ConnorBurken/CS498-IoT_Final_Project_Google_Glass/3D Printer Files/GG Part A v1.3.stl

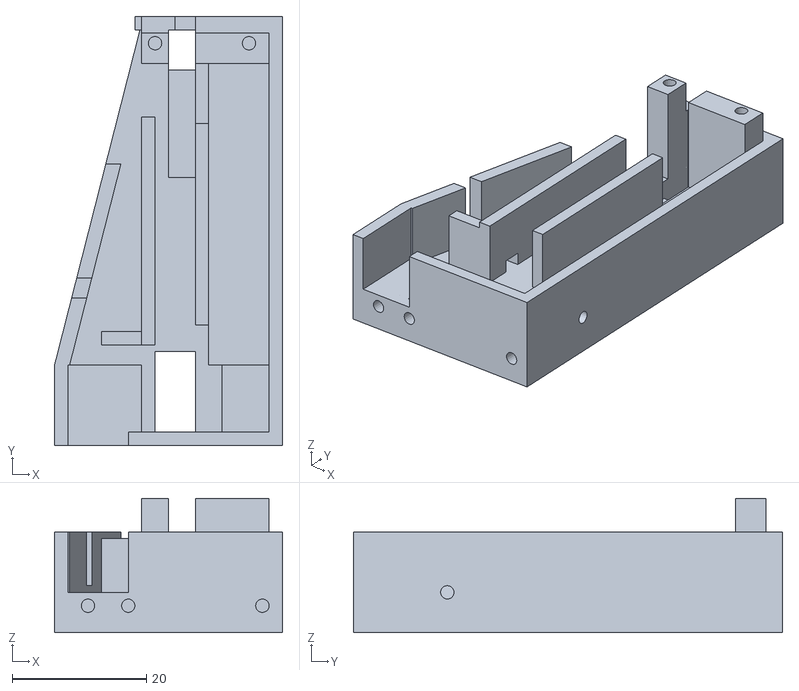
[picture p9: CAD file, 2023-01-03]
3D Printer Files/GG Part A v1.3.stl
34.0 x 64.0 x 20.0
