ConnorBurken/CS498-IoT_Final_Project_Google_Glass/3D Printer Files/GG Part H v1.3.stl

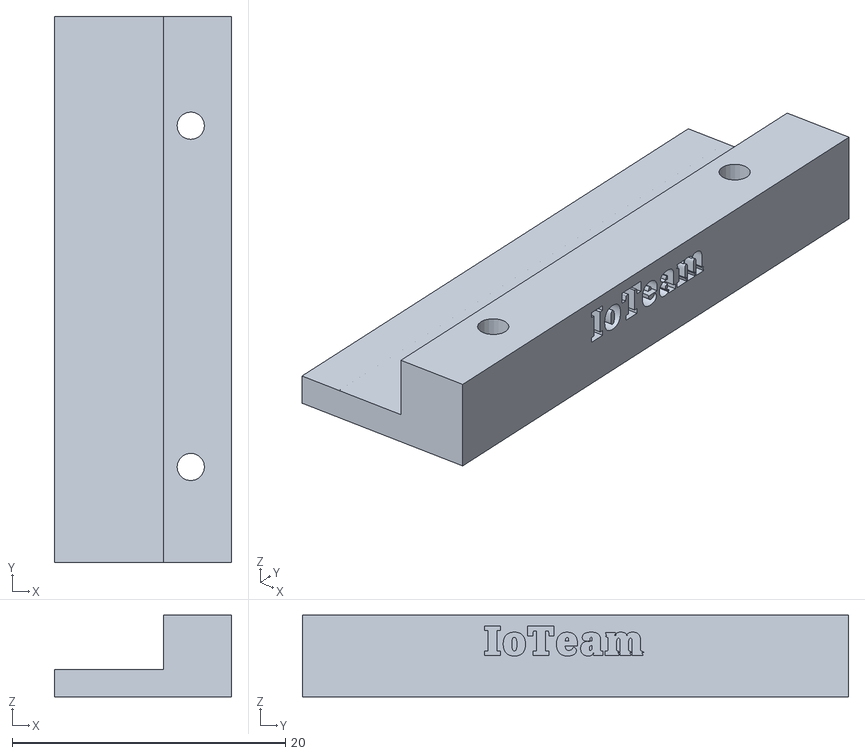
[picture p10: CAD file, 2023-01-03]
3D Printer Files/GG Part H v1.3.stl
13.0 x 40.0 x 6.00
