ConnorBurken/CS498-IoT_Final_Project_Google_Glass/3D Printer Files/GG Part E v1.3.stl

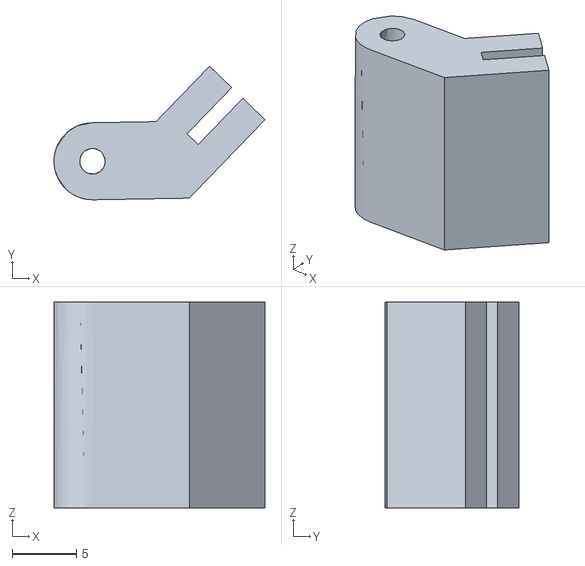
[picture p11: CAD file, 2023-01-03]
3D Printer Files/GG Part E v1.3.stl
16.4 x 10.4 x 16.0
