ConnorBurken/CS498-IoT_Final_Project_Google_Glass/3D Printer Files/Google_Glass_Test.stl

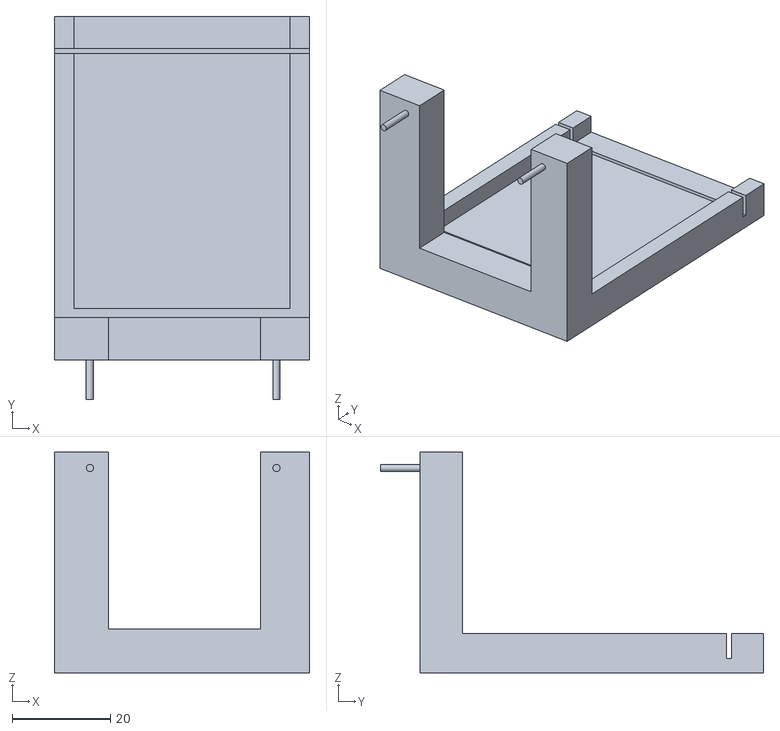
[picture p12: CAD file, 2023-01-03]
3D Printer Files/Google_Glass_Test.stl
52.0 x 78.0 x 45.0
