ConnorBurken/CS498-IoT_Final_Project_Google_Glass/3D Printer Files/part-b.stl

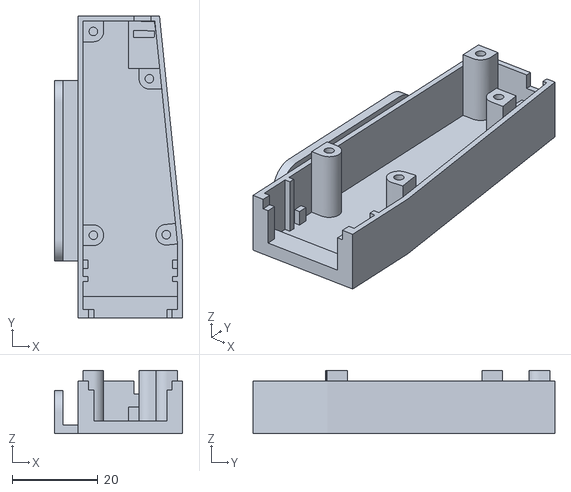
[picture p13: CAD file, 2023-01-03]
3D Printer Files/part-b.stl
29.9 x 70.3 x 14.7
