ConnorBurken/CS498-IoT_Final_Project_Google_Glass/3D Printer Files/Surprising Lappi.stl

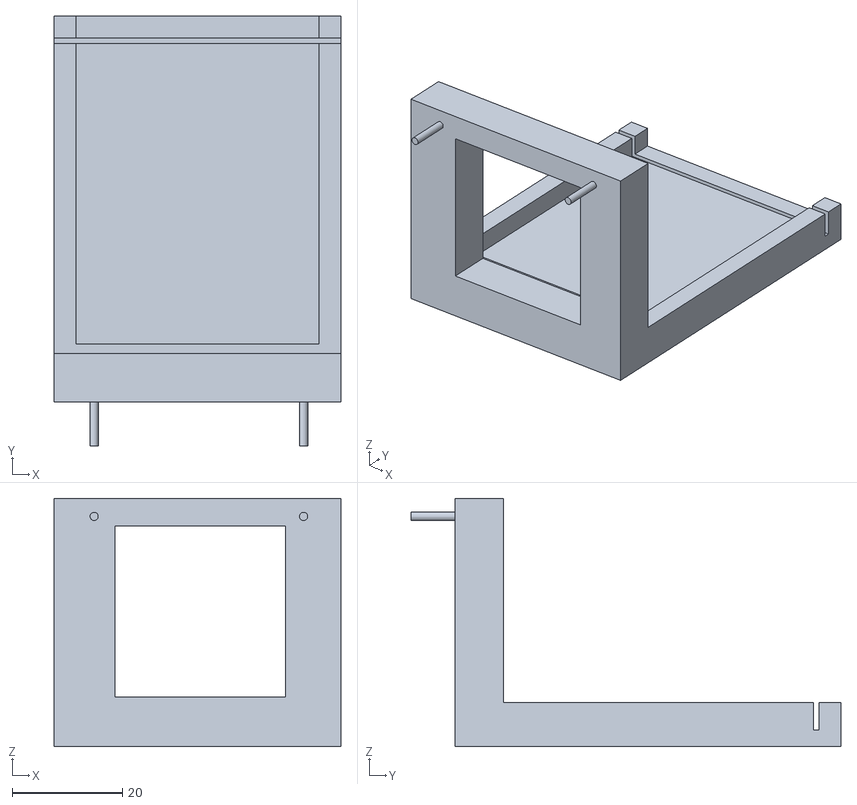
[picture p14: CAD file, 2023-01-03]
3D Printer Files/Surprising Lappi.stl
52.0 x 78.0 x 45.0
