ConnorBurken/CS498-IoT_Final_Project_Google_Glass/3D Printer Files/GG Part C1 v1.3.stl

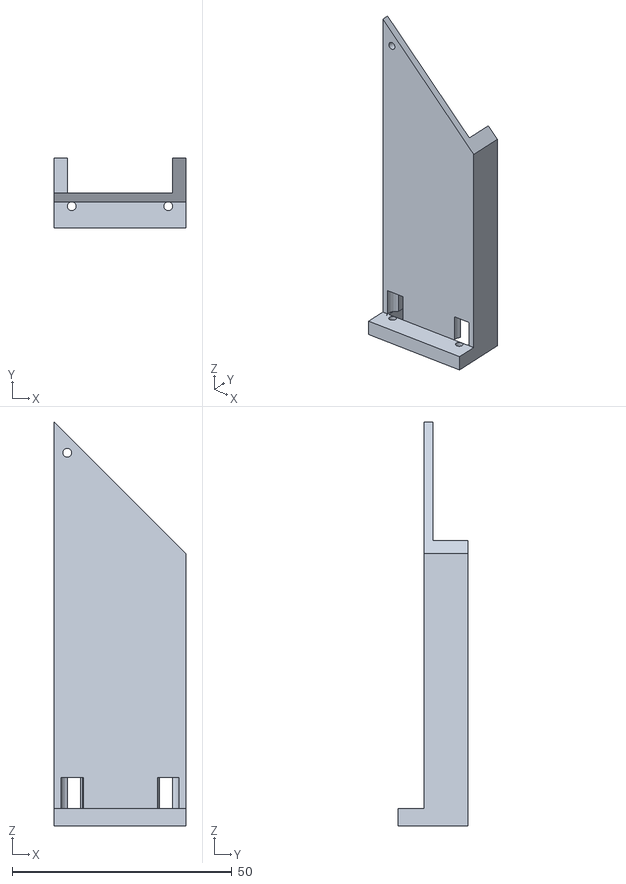
[picture p15: CAD file, 2023-01-03]
3D Printer Files/GG Part C1 v1.3.stl
30.0 x 16.0 x 92.0
