ConnorBurken/CS498-IoT_Final_Project_Google_Glass/3D Printer Files/Google Glass 0.95_.stl

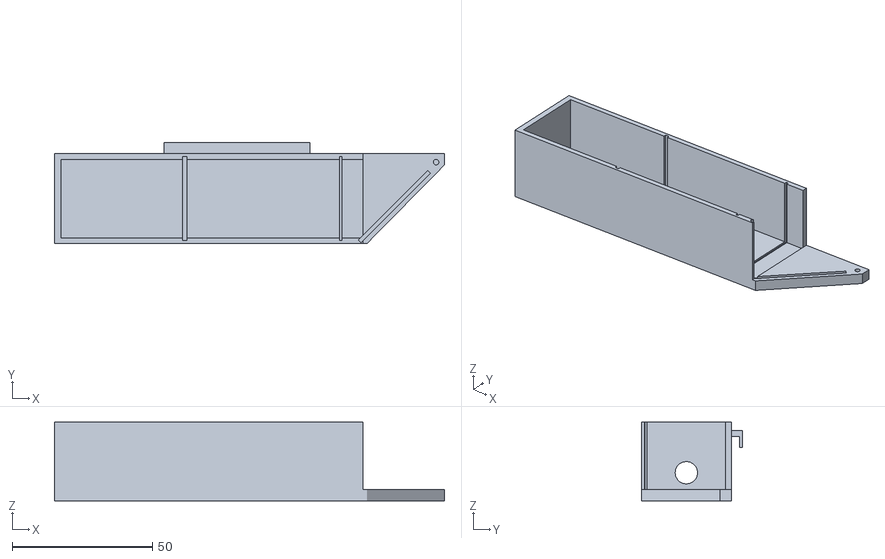
[picture p16: CAD file, 2023-01-03]
3D Printer Files/Google Glass 0.95_.stl
139.0 x 36.0 x 28.0
