ConnorBurken/CS498-IoT_Final_Project_Google_Glass/3D Printer Files/part-e-45b.stl

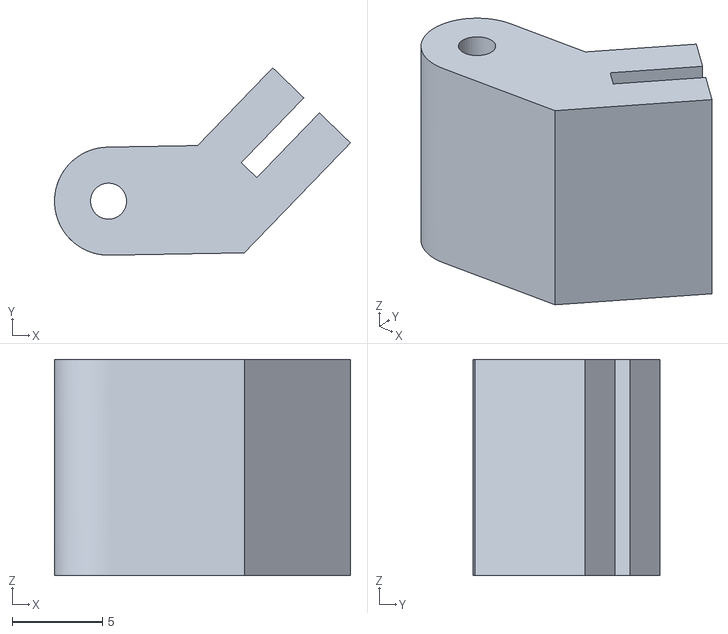
[picture p17: CAD file, 2023-01-03]
3D Printer Files/part-e-45b.stl
16.4 x 10.4 x 12.0
