ConnorBurken/CS498-IoT_Final_Project_Google_Glass/3D Printer Files/part-a.stl

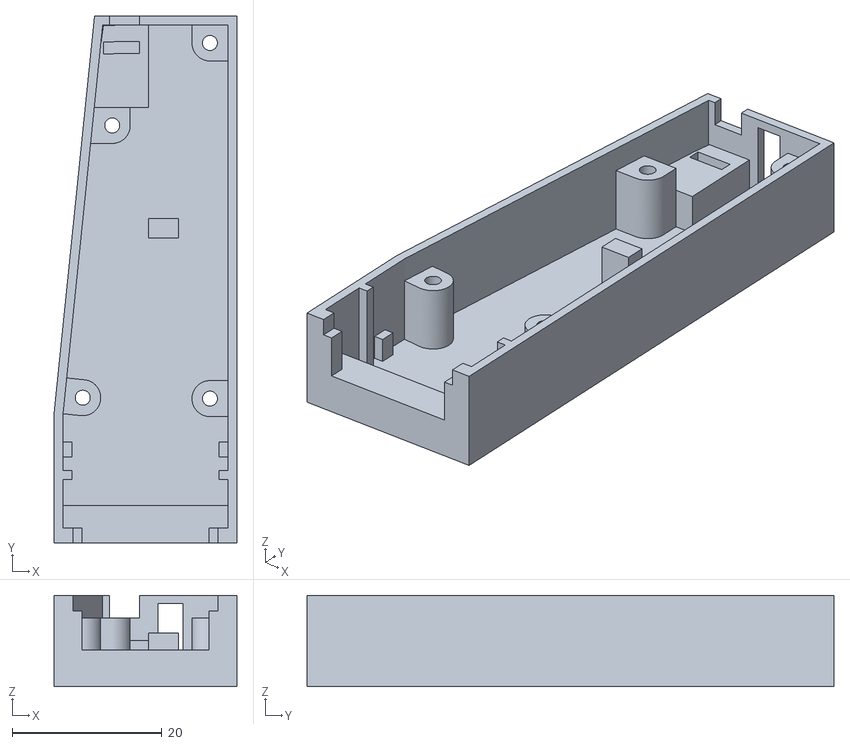
[picture p18: CAD file, 2023-01-03]
3D Printer Files/part-a.stl
24.4 x 70.3 x 12.2
