ConnorBurken/CS498-IoT_Final_Project_Google_Glass/3D Printer Files/Google Glass 0.96_ OLED Display GPS WiFi Part B.stl

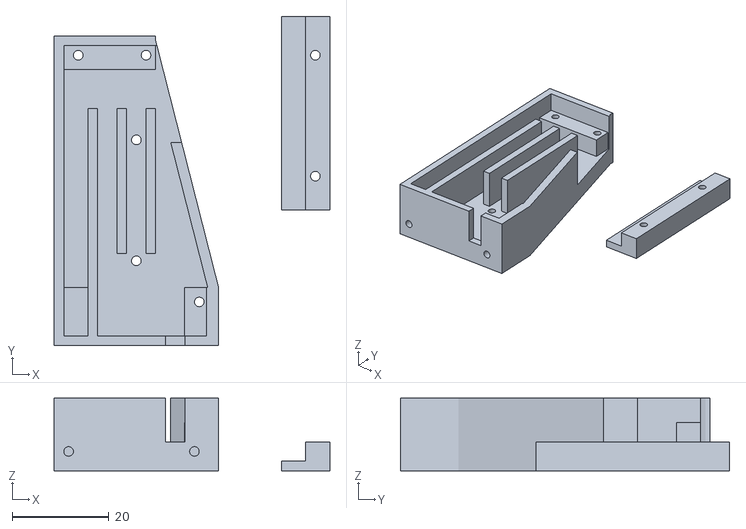
[picture p19: CAD file, 2023-01-03]
3D Printer Files/Google Glass 0.96_ OLED Display GPS WiFi Part B.stl
57.0 x 68.0 x 15.0
