ConnorBurken/CS498-IoT_Final_Project_Google_Glass/3D Printer Files/Google Glass 0.96_ OLED Display GPS WiFi Part A.stl

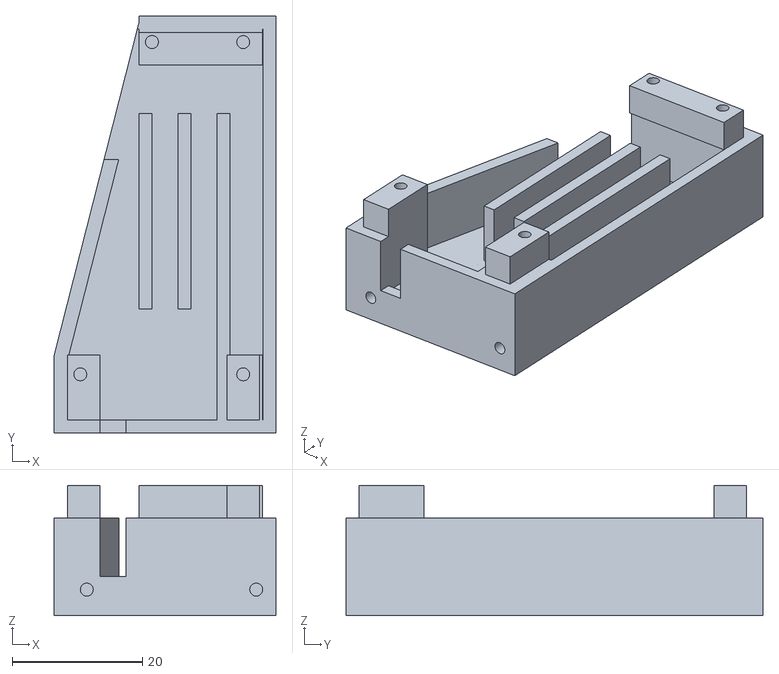
[picture p20: CAD file, 2023-01-03]
3D Printer Files/Google Glass 0.96_ OLED Display GPS WiFi Part A.stl
34.0 x 64.0 x 20.0
