ConnorBurken/CS498-IoT_Final_Project_Google_Glass/3D Printer Files/GG Part B v1.2.stl

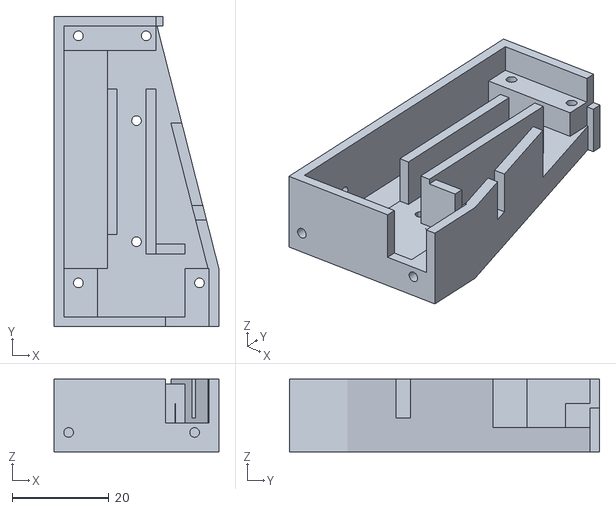
[picture p21: CAD file, 2023-01-03]
3D Printer Files/GG Part B v1.2.stl
34.0 x 64.0 x 15.0
