ConnorBurken/CS498-IoT_Final_Project_Google_Glass/3D Printer Files/GG Part C v1.1.stl

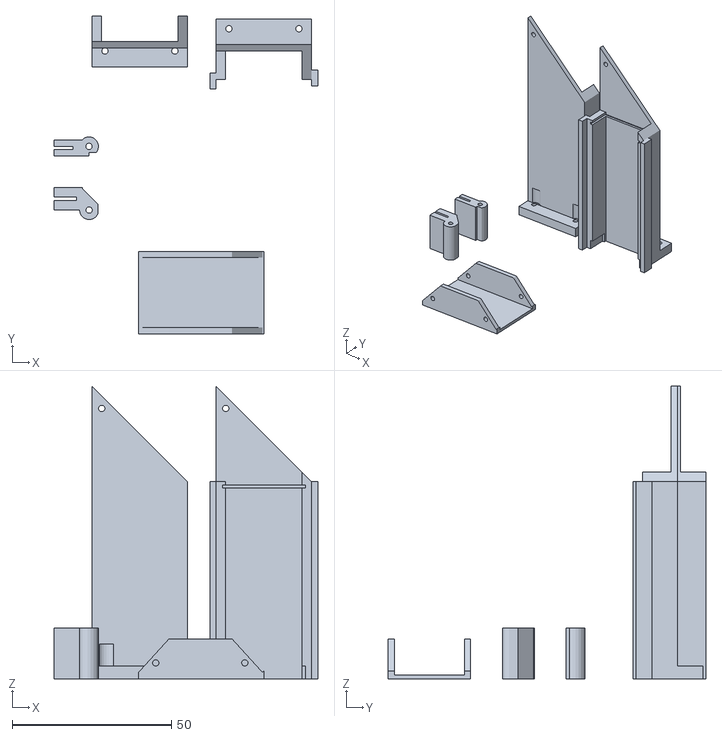
[picture p22: CAD file, 2023-01-03]
3D Printer Files/GG Part C v1.1.stl
83.0 x 100.0 x 92.0
