ConnorBurken/CS498-IoT_Final_Project_Google_Glass/3D Printer Files/GG Part AB v1.1.stl

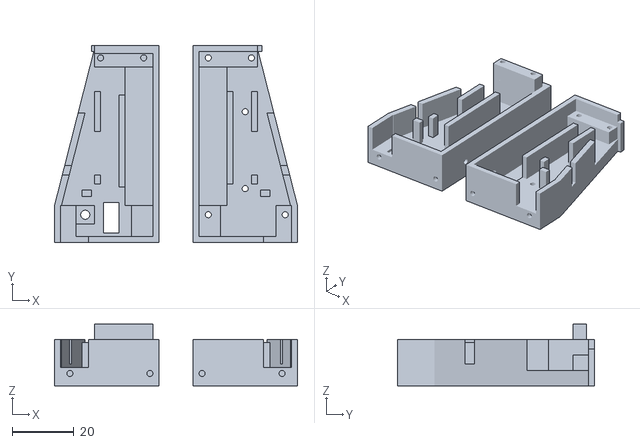
[picture p23: CAD file, 2023-01-03]
3D Printer Files/GG Part AB v1.1.stl
79.0 x 64.0 x 20.0
