ConnorBurken/CS498-IoT_Final_Project_Google_Glass/3D Printer Files/GG Part C2 v1.3.stl

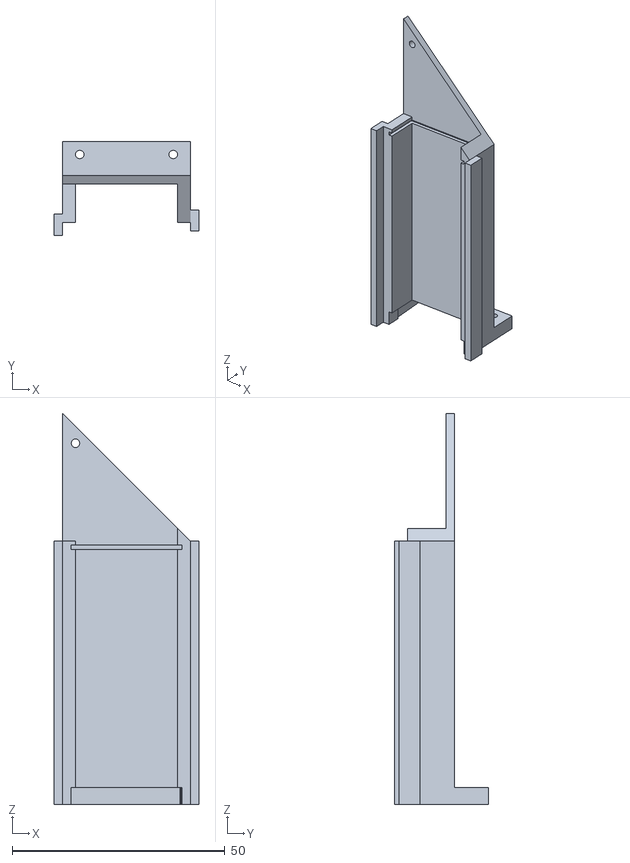
[picture p24: CAD file, 2023-01-03]
3D Printer Files/GG Part C2 v1.3.stl
34.0 x 22.0 x 92.0
