ConnorBurken/CS498-IoT_Final_Project_Google_Glass/3D Printer Files/part-c.stl

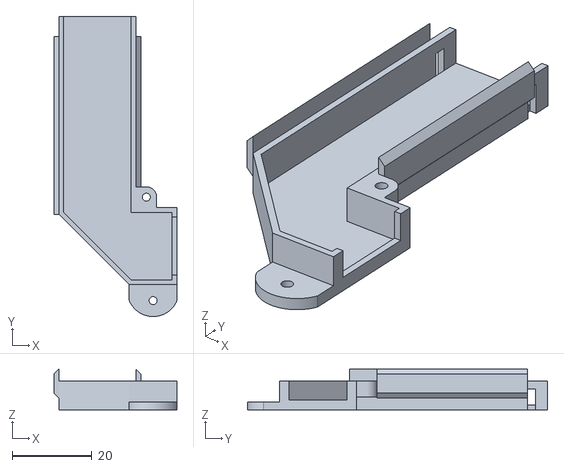
[picture p25: CAD file, 2023-01-03]
3D Printer Files/part-c.stl
30.9 x 75.4 x 10.2
