ConnorBurken/CS498-IoT_Final_Project_Google_Glass/3D Printer Files/part-d.stl

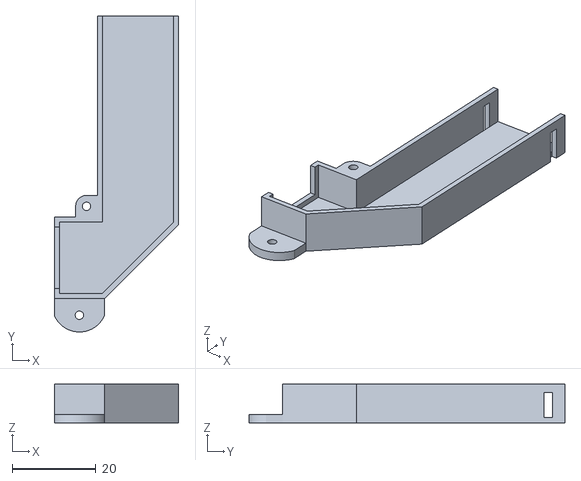
[picture p26: CAD file, 2023-01-03]
3D Printer Files/part-d.stl
29.7 x 75.4 x 9.20
