ConnorBurken/CS498-IoT_Final_Project_Google_Glass/3D Printer Files/GG Part D v1.2.stl

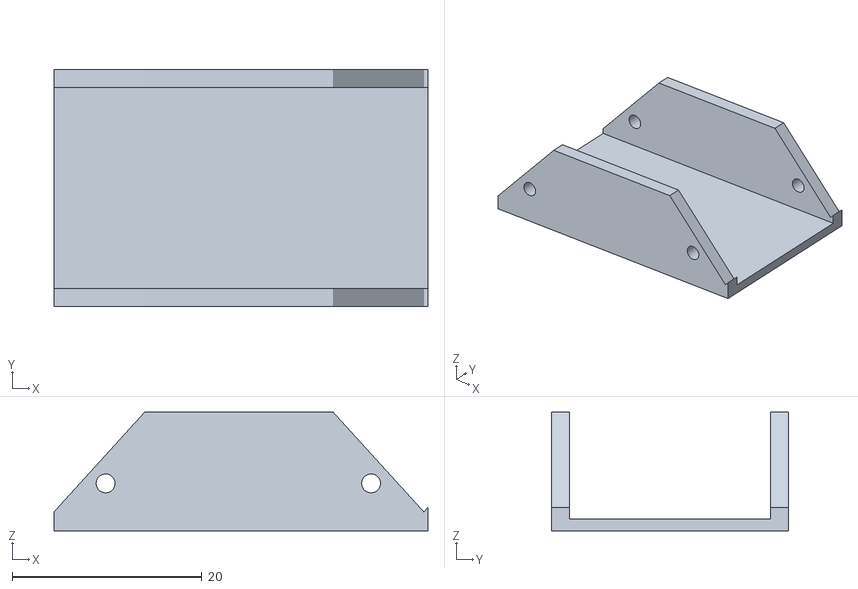
[picture p27: CAD file, 2023-01-03]
3D Printer Files/GG Part D v1.2.stl
39.4 x 25.0 x 12.5
