ConnorBurken/CS498-IoT_Final_Project_Google_Glass/(list of files, cad)

Other CAD files:
3D Printer Files/GG Part A v1.1 (1).stl
3D Printer Files/GG Part A v1.1.stl
3D Printer Files/GG Part A v1.2.stl
3D Printer Files/GG Part AB v1.1 (1).stl
3D Printer Files/GG Part B v1.1.stl
3D Printer Files/Google Glass 0.95_ (1).stl
