ConnorBurken/CS498-IoT_Final_Project_Google_Glass/fa20-cs498it-lab-final-main/agent/main.py

import websocket
try:
    import thread
except ImportError:
    import _thread as thread
import time

def on_message(ws, message):
    print("\nincoming: " + message + "\n")

def on_error(ws, error):
    print(error)

def on_close(ws):
    print("### closed ###")

def on_open(ws):
    def run(*args):
        while True:
            name = input("outgoing msg: ")
            ws.send(name)
        # ws.close()
        # print("thread terminating...")
    thread.start_new_thread(run, ())


if __name__ == "__main__":
    websocket.enableTrace(True)
    ws = websocket.WebSocketApp("ws://9ca646f7fe81.ngrok.io/client",
                              on_message = on_message,
                              on_error = on_error,
                              on_close = on_close)
    ws.on_open = on_open
    ws.run_forever()
