ConnorBurken/CS498-IoT_Final_Project_Google_Glass/fa20-cs498it-lab-final-main/agent/ble_test01.py

from adafruit_ble import BLERadio

radio = BLERadio()
print("scanning")
found = set()
for entry in radio.start_scan(timeout=60, minimum_rssi=-80):
    addr = entry.address
    if addr not in found:
        print(entry)
    found.add(addr)

print("scan done")
